gerikkub/CPRC-IGVC/Images/justin kyle working.jpg

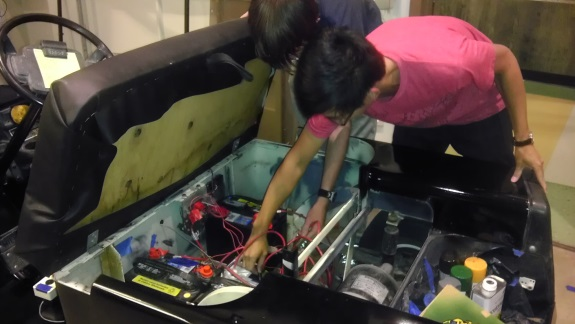
Images/justin kyle working.jpg
