gerikkub/CPRC-IGVC/Images/team work.jpg

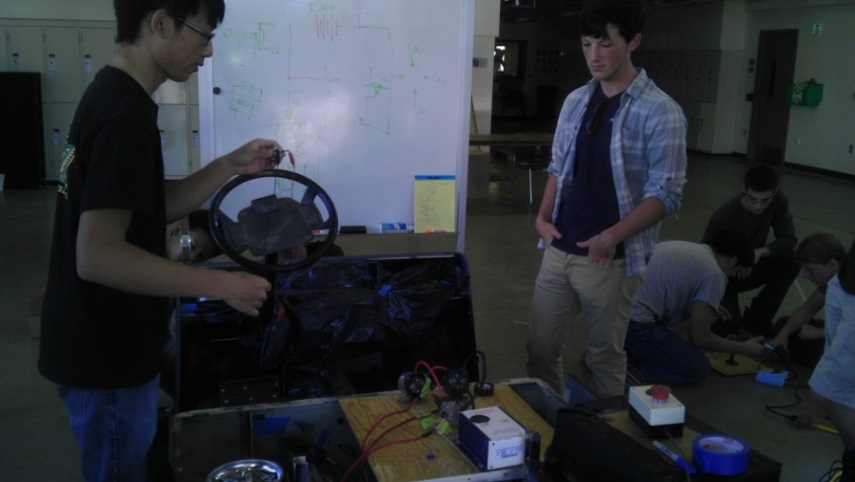
Images/team work.jpg
