gerikkub/CPRC-IGVC/README.md

This is the code repository for the CPRC IGVC project.
Before you commit any changes, please follow the format and inform Jordan Lin
