gerikkub/CPRC-IGVC/Electrical Schematics/IGCV/Images/EZdrive.png

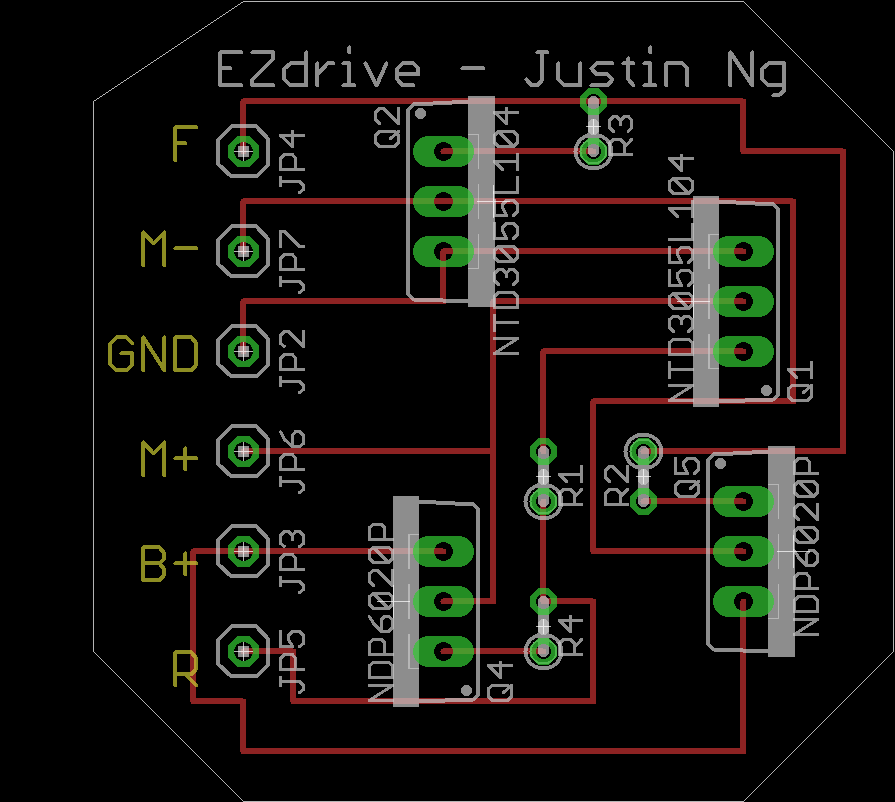
Electrical Schematics/IGCV/Images/EZdrive.png
