gerikkub/CPRC-IGVC/Electrical Schematics/IGCV/Images/FNR Controller v0.0.png

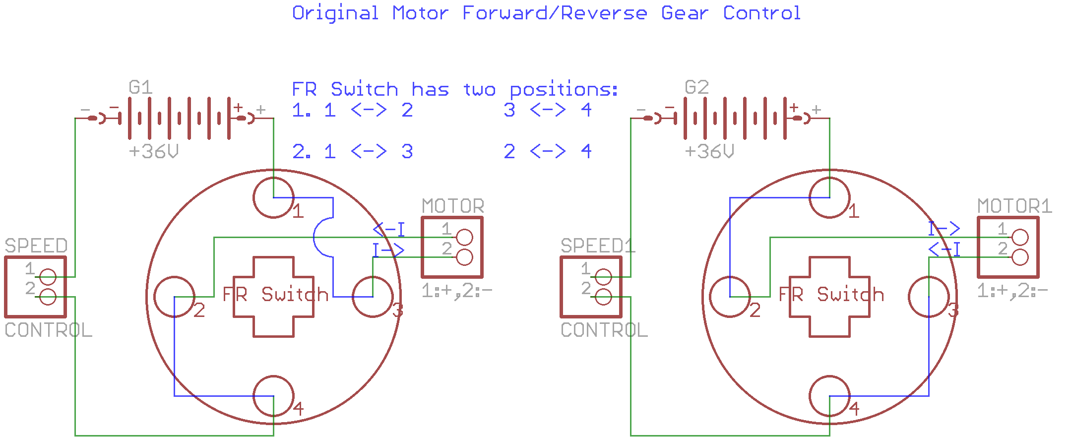
Electrical Schematics/IGCV/Images/FNR Controller v0.0.png
