gerikkub/CPRC-IGVC/Electrical Schematics/IGCV/Images/FNR Controller v1.0 - Relay.png

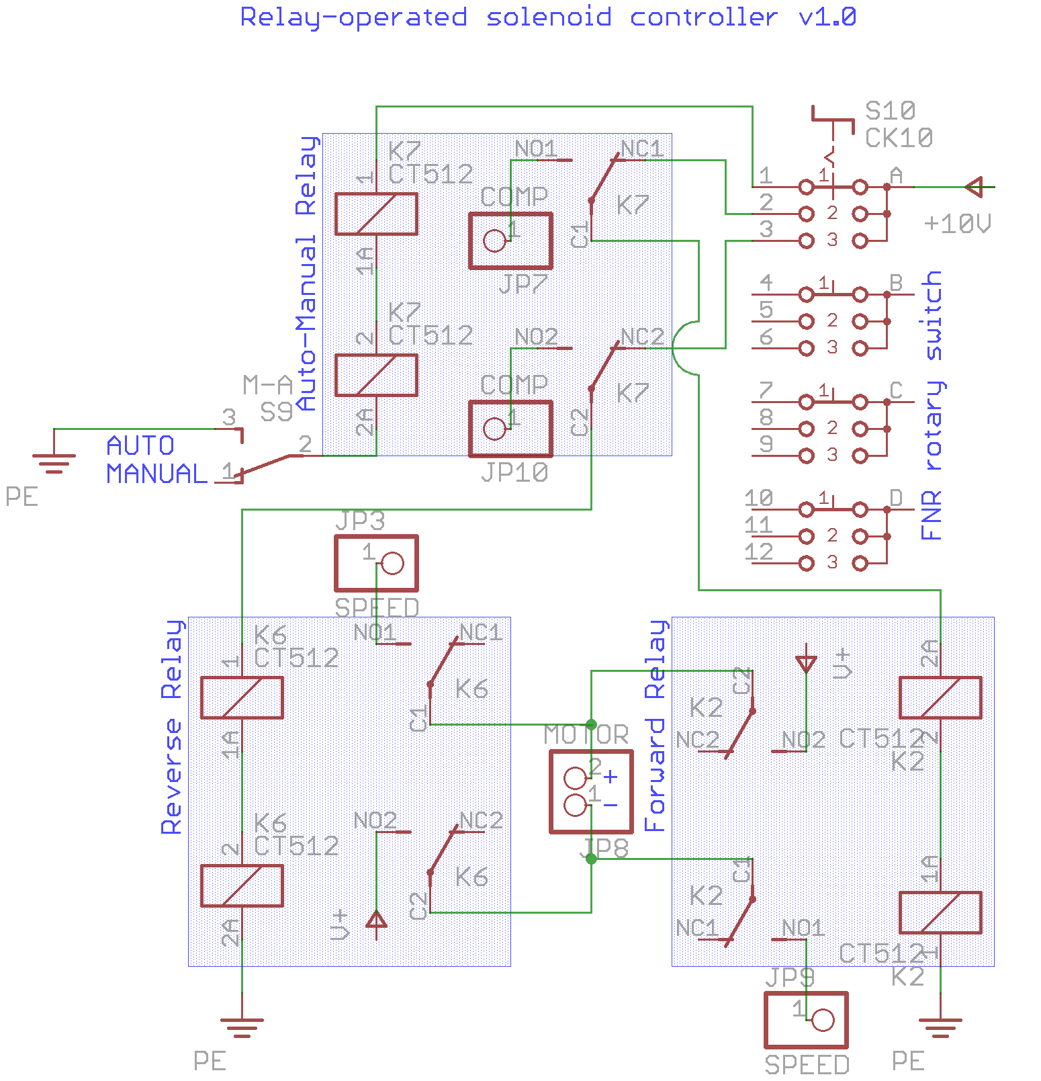
Electrical Schematics/IGCV/Images/FNR Controller v1.0 - Relay.png
