gerikkub/CPRC-IGVC/Electrical Schematics/IGCV/Images/FNR Controller v1.1 - Relay.png

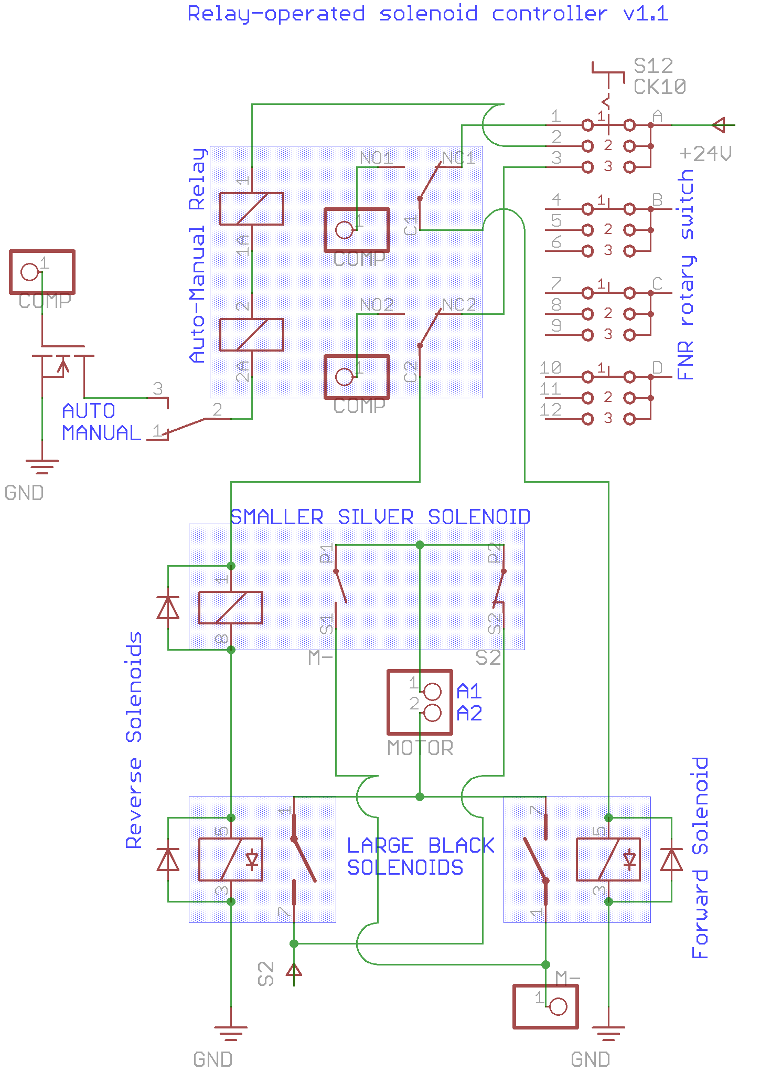
Electrical Schematics/IGCV/Images/FNR Controller v1.1 - Relay.png
