gerikkub/CPRC-IGVC/Electrical Schematics/IGCV/Images/FNR Controller v1.2 - Solid state.png

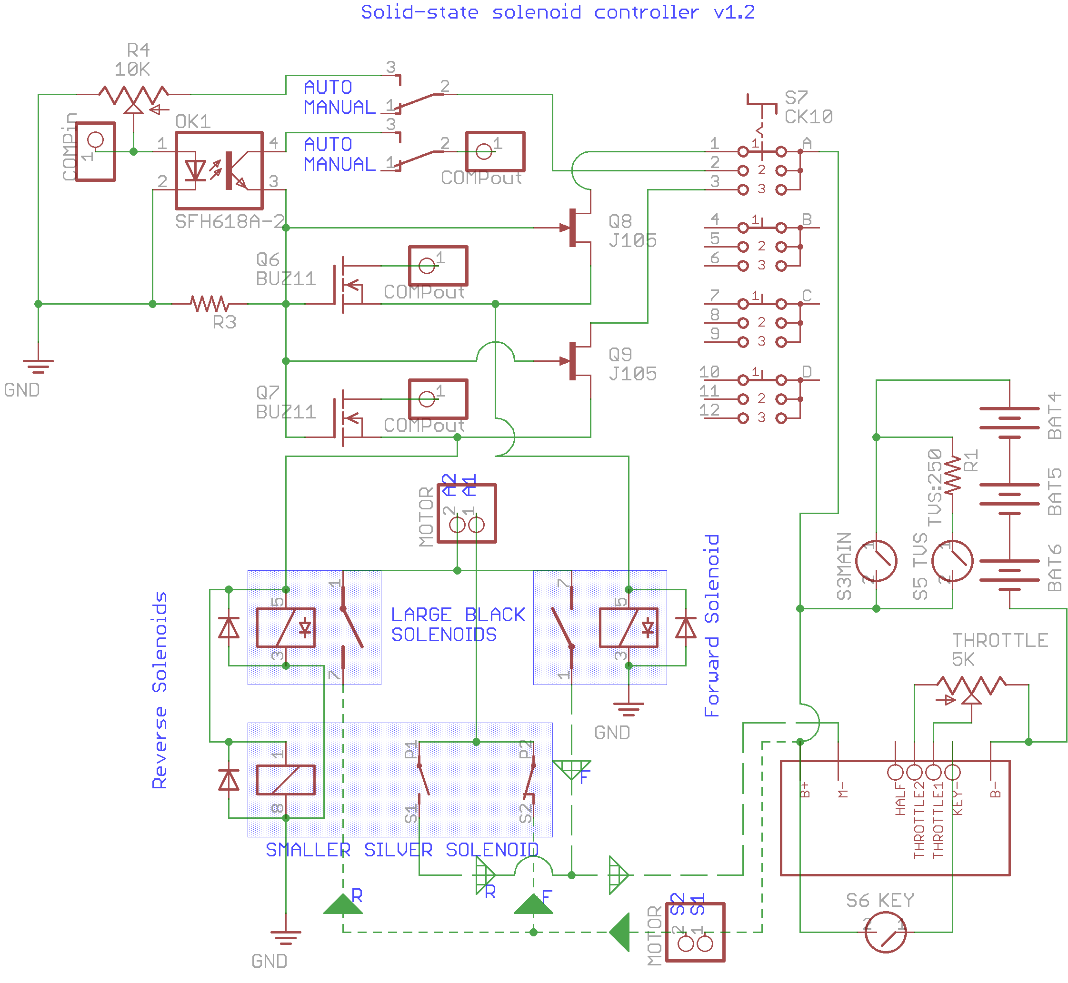
Electrical Schematics/IGCV/Images/FNR Controller v1.2 - Solid state.png
