gerikkub/CPRC-IGVC/Electrical Schematics/IGCV/Images/FNR v1.4 + Speed v1.2.png

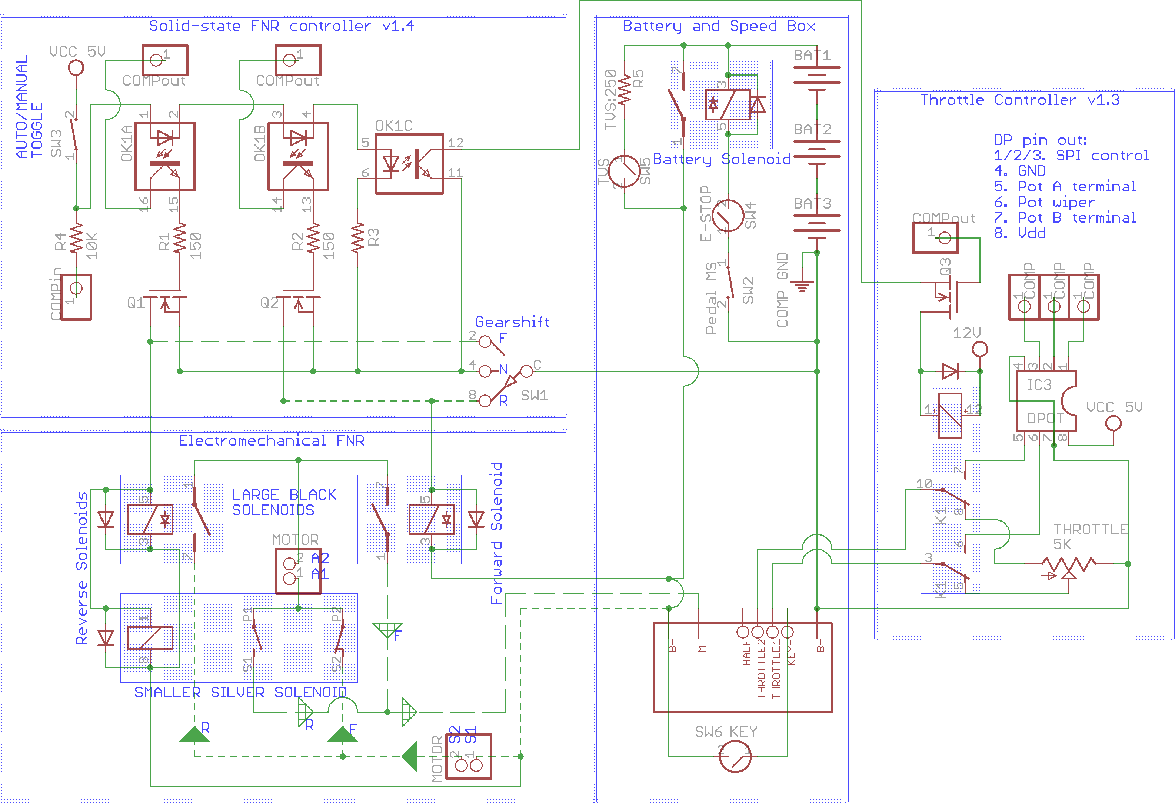
Electrical Schematics/IGCV/Images/FNR v1.4 + Speed v1.2.png
