gerikkub/CPRC-IGVC/Electrical Schematics/IGCV/Images/IGVC Controller v1.6.png

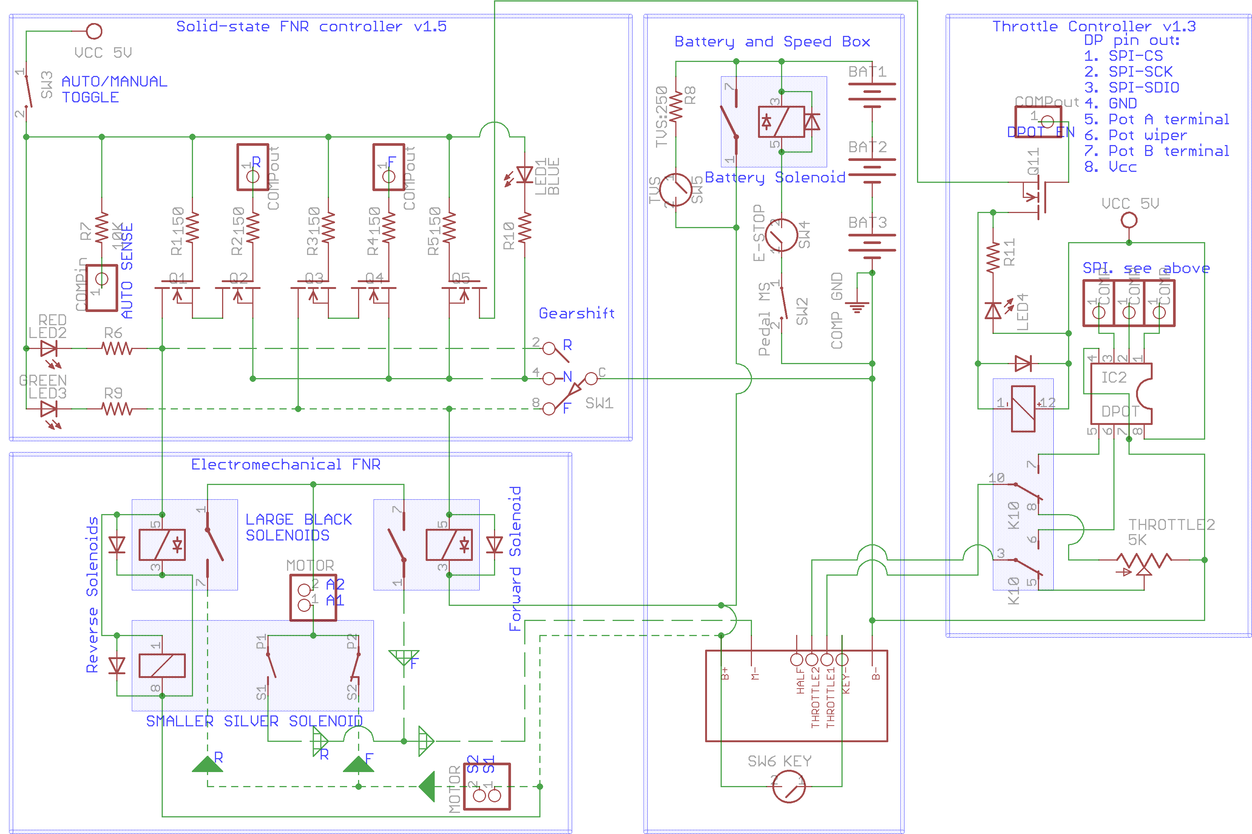
Electrical Schematics/IGCV/Images/IGVC Controller v1.6.png
