gerikkub/CPRC-IGVC/Electrical Schematics/IGCV/Images/Speed Controller v1.0.png

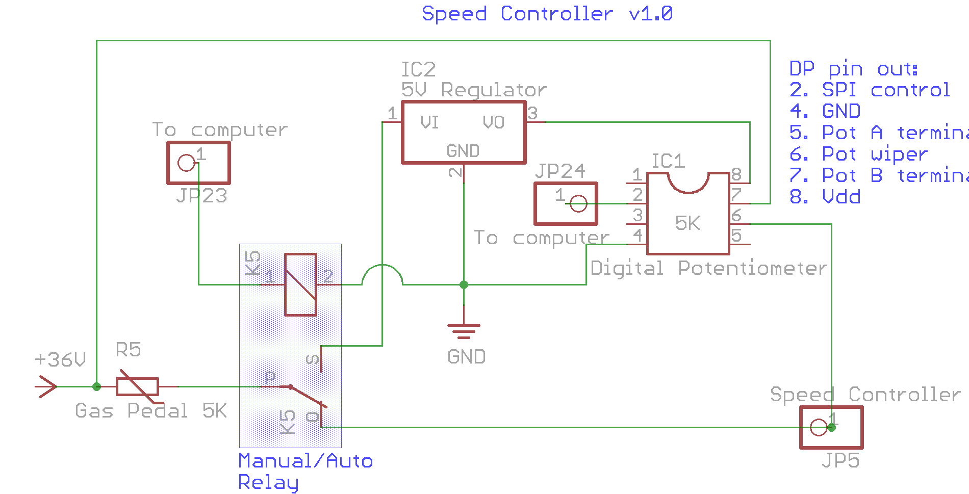
Electrical Schematics/IGCV/Images/Speed Controller v1.0.png
