gerikkub/CPRC-IGVC/Images/DSC_0002.JPG

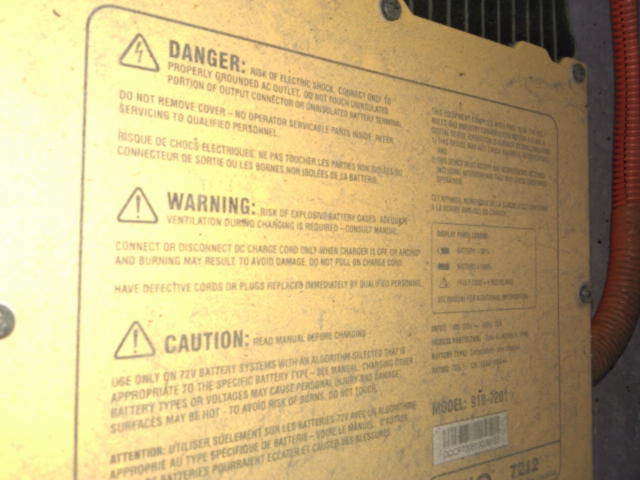
Images/DSC_0002.JPG
