gerikkub/CPRC-IGVC/Images/vehicle.jpg

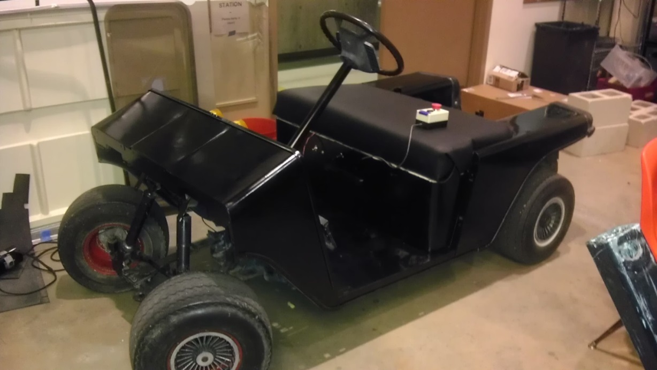
Images/vehicle.jpg
