gerikkub/CPRC-IGVC/Code/Software Implementation/FunctionsTest.xlsx

FUNCTIONS | WORKING | NOT WORKING
void setFNR(int FNR)
STEERING
void turn(float input)
void SetSteeringAngle(int targetAngle)
void Straighten( )
READING VALUES
int readUSensor(int sensor)
int readSteering(int pin)
int readHallEffects(int pin)
int readAMS(int pin)
float sideAngleToWall(int side)
NETWORKING
String toJSON( )
int dealWithInput( )
void parseJson( )
AVOIDANCE
void shyAway( )
void parallelToWall( )
