gerikkub/CPRC-IGVC/Electrical Schematics/IGCV/FNR Build day test.sch

## EAGLE design Electrical Schematics/IGCV/FNR Build day test.sch (2013-10-28)

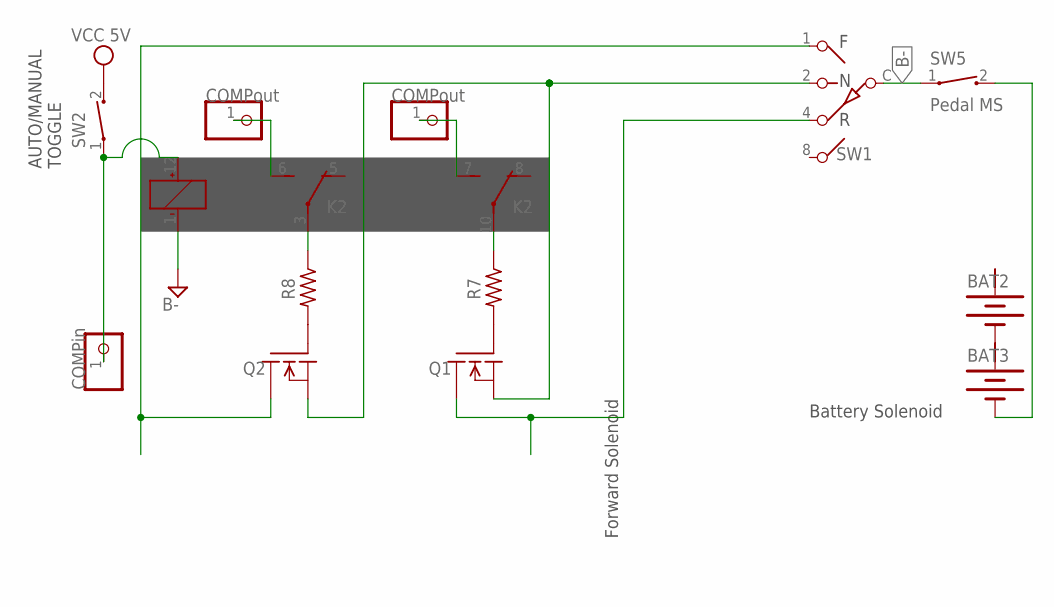
[picture p14: schematic FNR Build day test.sch]

Parts:
BAT2, BAT3: BATTERY
JP4, JP22: COMPout; 1X01
JP6: COMPin; 1X01
K2: DF2-L-DC24V; DF2
Q1, Q2: BUZ11; TO220
R7, R8: R-US_0204/5; 0204/5
SW1: SW-C10
SW2, SW5: Pedal MS; CT10-XXXX-A2

Connections:
B-: BAT3.-, Q1.3 (S), Q2.3 (S), SW1.2, SW5.2
FGND: Q1.2 (D), SW1.4
GND1: K2.1 (-)
unnamed: JP4.1, K2.6 (S)
unnamed: JP22.1, K2.7 (S)
unnamed: BAT2.-, BAT3.+
unnamed: K2.10, R7.1
unnamed: Q2.1 (G), R8.2
unnamed: Q1.1 (G), R7.2
unnamed: K2.3, R8.1
unnamed: JP6.1, K2.12 (+), SW2.1
unnamed: SW1.C, SW5.1
RGND: Q2.2 (D), SW1.1
VCC: SW2.2

Notes on the sheet:
Forward Solenoid
AUTO/MANUAL TOGGLE
Battery Solenoid
F N R
