gerikkub/CPRC-IGVC/Electrical Schematics/IGCV/FNR Controller v0.0 - Original.sch

## EAGLE design Electrical Schematics/IGCV/FNR Controller v0.0 - Original.sch (2013-10-28)

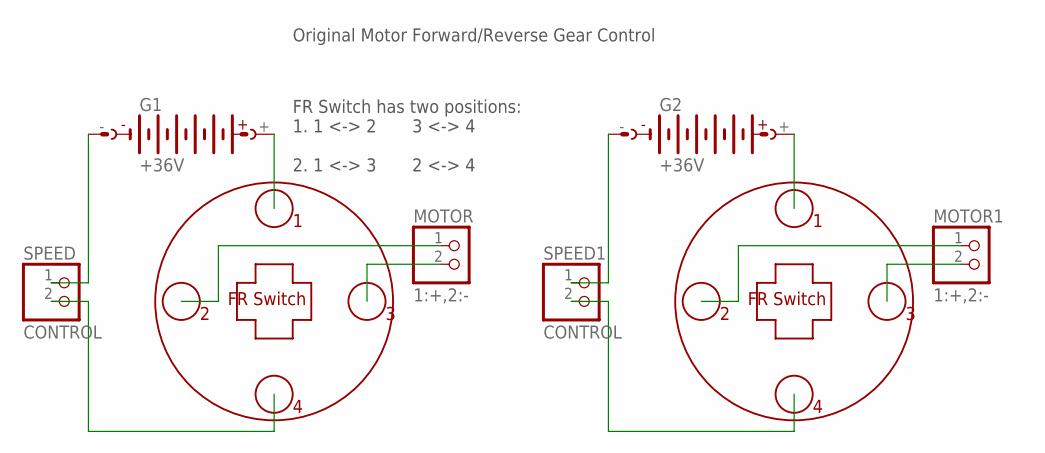
[picture p15: schematic FNR Controller v0.0 - Original.sch]

Parts:
G1, G2: +36V; AB9V
MOTOR, MOTOR1: 1:+,2:-; 1X02
SPEED, SPEED1: CONTROL; 1X02
U$1, U$3: FRSWITCH; DIL08-ROUND

Connections:
unnamed: G1.+, U$1.1
unnamed: G1.-, SPEED.1
unnamed: SPEED.2, U$1.4
unnamed: MOTOR.2, U$1.2
unnamed: MOTOR.1, U$1.3
unnamed: G2.+, U$3.1
unnamed: G2.-, SPEED1.1
unnamed: SPEED1.2, U$3.4
unnamed: MOTOR1.2, U$3.2
unnamed: MOTOR1.1, U$3.3

Notes on the sheet:
FR Switch has two positions: 1. 1 <-> 2 3 <-> 4 2. 1 <-> 3 2 <-> 4
Original Motor Forward/Reverse Gear Control
