gerikkub/CPRC-IGVC/Electrical Schematics/IGCV/FNR Controller v1.0 - Relay.sch

## EAGLE design Electrical Schematics/IGCV/FNR Controller v1.0 - Relay.sch (2013-10-28, an earlier design)

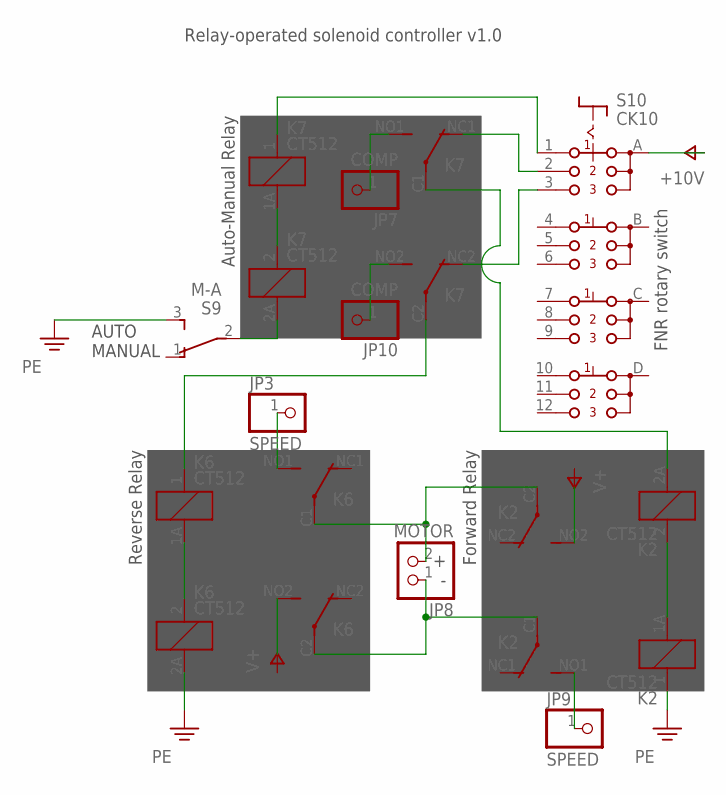
[picture p16: schematic FNR Controller v1.0 - Relay.sch]

Parts:
JP3, JP9: SPEED; 1X01
JP7, JP10: COMP; 1X01
JP8: MOTOR; 1X02
K2, K6, K7: CT512; CT2-TWIN
S9: M-A; TL3XPO
S10: CK10

Connections:
unnamed: JP8.1, K2.C1, K6.C2
unnamed: JP8.2, K2.C2, K6.C1
unnamed: K6.1A (2), K6.2 (1)
unnamed: K2.1A (2), K2.2 (1)
unnamed: JP9.1, K2.NO1 (S)
unnamed: JP3.1, K6.NO1 (S)
unnamed: K6.1, K7.C2
unnamed: K7.1A (2), K7.2 (1)
unnamed: K7.2A (2), S9.2
unnamed: JP7.1, K7.NO1 (S)
unnamed: JP10.1, K7.NO2 (S)
unnamed: K7.1, S10.1 (A1)
unnamed: K7.NC1 (O), S10.2 (A2)
unnamed: K7.NC2 (O), S10.3 (A3)
unnamed: K2.2A (2), K7.C1
PE: K2.1, K6.2A (2), S9.3 (S)
V+: S10.A

Notes on the sheet:
+ -
AUTO MANUAL
FNR rotary switch
Auto-Manual Relay
Forward Relay
Reverse Relay
Relay-operated solenoid controller v1.0
