gerikkub/CPRC-IGVC/Electrical Schematics/IGCV/FNR Controller v1.1 - Relay.sch

## EAGLE design Electrical Schematics/IGCV/FNR Controller v1.1 - Relay.sch (2013-10-28)

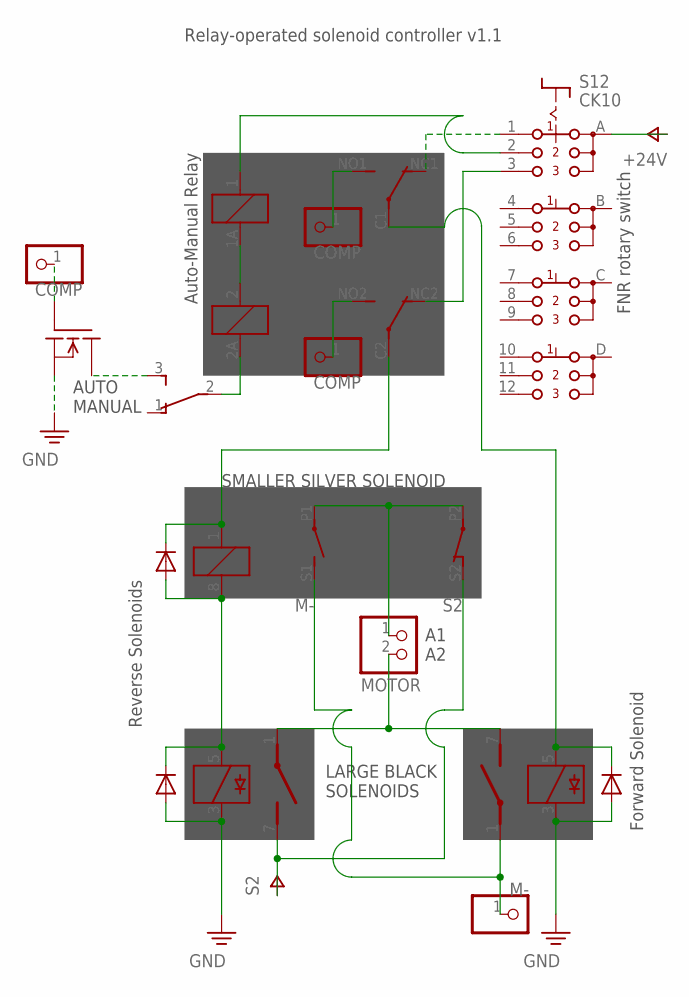
[picture p17: schematic FNR Controller v1.1 - Relay.sch]

Parts:
D4, D5, D6: 1N4004; DO41-10
JP12, JP20, JP21: COMP; 1X01
JP18: MOTOR; 1X02
JP19: M-; 1X01
K11: CT512; CT2-TWIN
K12, K13: 35701331; REED
K14: G6C-2117P
Q3: BUZ11; TO220
S11: M-A; TL3XPO
S12: CK10

Connections:
M-: JP19.1, K13.1, K14.S1 (S)
unnamed: JP18.2, K12.1, K13.7 (S)
unnamed: D5.C, K11.C2, K14.1
unnamed: K11.1A (2), K11.2 (1)
unnamed: K11.2A (2), S11.2
unnamed: JP12.1, K11.NO1 (S)
unnamed: JP20.1, K11.NO2 (S)
unnamed: K11.1, S12.2 (A2)
unnamed: D4.C, D5.A, K12.5, K14.8 (2)
unnamed: JP18.1, K14.P1, K14.P2
unnamed: Q3.2 (D), S11.3 (S)
unnamed: JP21.1, Q3.1 (G)
unnamed: K11.NC1 (O), S12.1 (A1)
unnamed: K11.NC2 (O), S12.3 (A3)
unnamed: D6.C, K11.C1, K13.5
PE: D4.A, D6.A, K12.3, K13.3, Q3.3 (S)
S2: K12.7 (S), K14.S2 (O), S12.A

Notes on the sheet:
A1 A2
AUTO MANUAL
FNR rotary switch
Auto-Manual Relay
Forward Solenoid
Reverse Solenoids
SMALLER SILVER SOLENOID
LARGE BLACK SOLENOIDS
Relay-operated solenoid controller v1.1
