gerikkub/CPRC-IGVC/Electrical Schematics/IGCV/FNR Controller v1.2 - Solid state.sch

## EAGLE design Electrical Schematics/IGCV/FNR Controller v1.2 - Solid state.sch (2013-10-28)

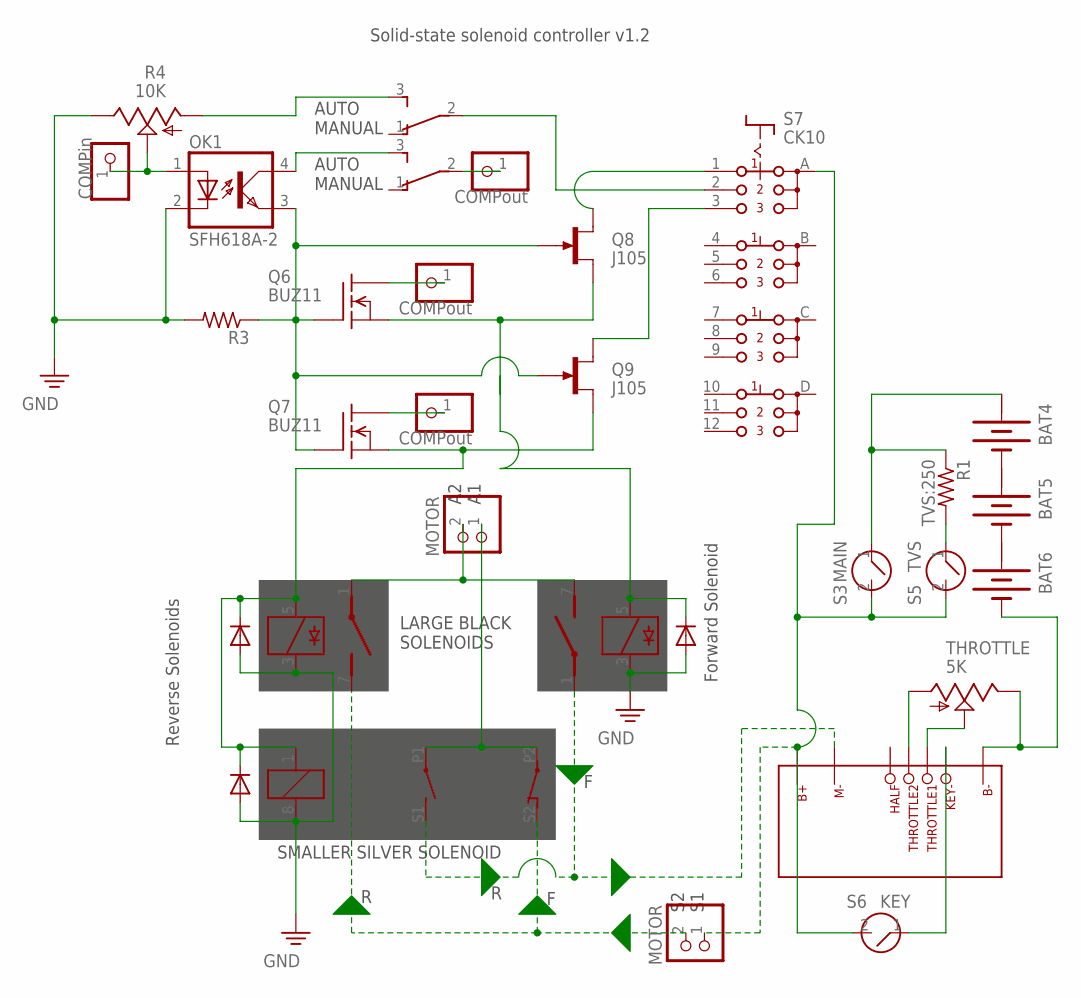
[picture p18: schematic FNR Controller v1.2 - Solid state.sch]

Parts:
BAT4, BAT5, BAT6: BATTERY
D7, D8, D9: 1N4004; DO41-10
JP11, JP13: MOTOR; 1X02
JP14, JP15, JP17: COMPout; 1X01
JP16: COMPin; 1X01
K8, K9: 35701331; REED
K10: G6C-2117P
OK1: SFH618A-2; DIP4
Q6, Q7: BUZ11; TO220
Q8, Q9: J105; TO92R
R1: TVS:250; 0204/5
R3: R-US_0204/5; 0204/5
R4: 10K; CT6
S2, S8: M-A; TL3XPO
S3: MAIN; SWITCH
S5: TVS; SWITCH
S6: KEY; SWITCH
S7: CK10
THROTTLE: 5K; CT6
U$2: MOTOR-CONTROLLER

Connections:
unnamed: OK1.3 (EMIT), Q6.1 (G), Q7.1 (G), Q8.G, Q9.G, R3.1
unnamed: JP16.1, OK1.1 (A), R4.S
unnamed: D7.C, D8.C, K8.5, K10.1, Q7.3 (S), Q9.S
unnamed: JP13.1, S3.2, S5.2, S6.2, S7.A, U$2.P$2 (B+)
unnamed: JP13.2, K8.7 (S), K10.S2 (O)
unnamed: JP17.1, S2.2
unnamed: Q8.D, S7.1 (A1)
unnamed: OK1.4 (COL), S2.3 (S)
unnamed: BAT4.+, R1.1, S3.1
unnamed: R1.2, S5.1
unnamed: JP11.2, K8.1, K9.7 (S)
unnamed: JP11.1, K10.P1, K10.P2
unnamed: BAT4.-, BAT5.+
unnamed: BAT5.-, BAT6.+
unnamed: THROTTLE.S, U$2.P$5 (THROTTLE1)
unnamed: S6.1, U$2.P$4 (KEY-)
unnamed: K9.1, K10.S1 (S), U$2.P$3 (M-)
unnamed: Q9.D, S7.3 (A3)
unnamed: D9.C, K9.5, Q6.3 (S), Q8.S
unnamed: JP14.1, Q6.2 (D)
unnamed: JP15.1, Q7.2 (D)
unnamed: S7.2 (A2), S8.2
unnamed: R4.A, S8.3 (S)
unnamed: BAT6.-, THROTTLE.E, U$2.P$1 (B-)
unnamed: THROTTLE.A, U$2.P$6 (THROTTLE2)
PE: D7.A, D8.A, D9.A, K8.3, K9.3, K10.8 (2), OK1.2 (C), R3.2, R4.E

Notes on the sheet:
A2 A1
Forward Solenoid
Reverse Solenoids
SMALLER SILVER SOLENOID
LARGE BLACK SOLENOIDS
S2 S1
AUTO MANUAL
Solid-state solenoid controller v1.2
