gerikkub/CPRC-IGVC/Electrical Schematics/IGCV/FNR v1.3 + Speed v1.2.sch

## EAGLE design Electrical Schematics/IGCV/FNR v1.3 + Speed v1.2.sch (2013-10-28, an earlier design)

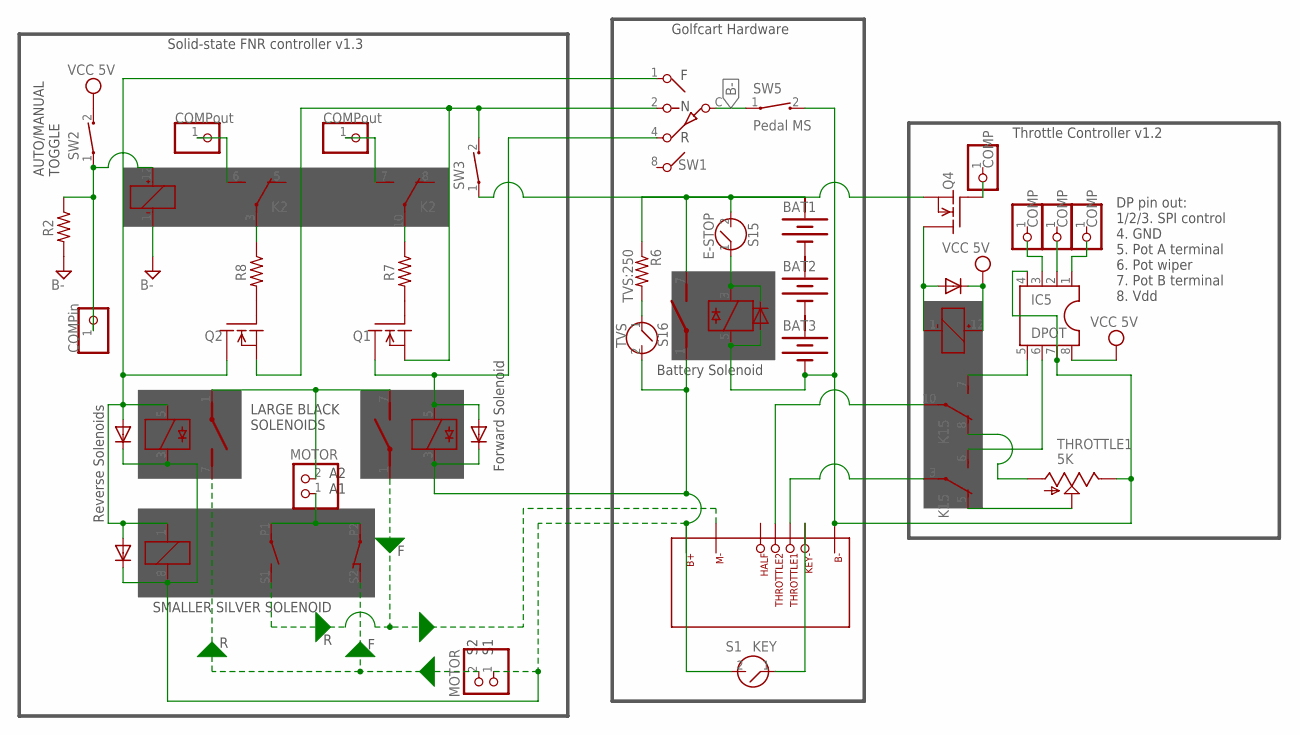
[picture p19: schematic FNR v1.3 + Speed v1.2.sch]

Parts:
BAT1, BAT2, BAT3: BATTERY
D1, D2, D3, D10, D11: 1N4004; DO41-10
IC5: DPOT; DIL08
JP1, JP2: MOTOR; 1X02
JP4, JP22: COMPout; 1X01
JP6: COMPin; 1X01
JP25, JP26, JP27, JP28: COMP; 1X01
K1, K3, K16: 35701331; REED
K2, K15: DF2-L-DC24V; DF2
K4: G6C-2117P
Q1, Q2, Q4: BUZ11; TO220
R2, R7, R8: R-US_0204/5; 0204/5
R6: TVS:250; 0204/5
S1: KEY; SWITCH
S15: E-STOP; SWITCH
S16: TVS; SWITCH
SW1: SW-C10
SW2, SW3, SW5: Pedal MS; CT10-XXXX-A2
THROTTLE1: 5K; CT6
U$4: MOTOR-CONTROLLER

Connections:
A1: JP1.1, K4.P1, K4.P2
A2: JP1.2, K1.1, K3.7 (S)
B+: D1.C, D2.C, D3.C, JP2.1, JP2.2, K1.3, K1.7 (S), K3.3, K4.8 (2), K4.S2 (O), K16.1, S1.2, S16.2, U$4.P$2 (B+)
B-: BAT3.-, D11.A, IC5.4, IC5.7, K16.5, Q1.3 (S), Q2.3 (S), SW1.2, SW3.2, SW5.2, THROTTLE1.E, U$4.P$1 (B-)
FGND: D3.A, K3.5, Q1.2 (D), SW1.4
GND1: K2.1 (-), R2.2
M-: K3.1, K4.S1 (S), U$4.P$3 (M-)
unnamed: JP4.1, K2.6 (S)
unnamed: JP22.1, K2.7 (S)
unnamed: Q4.3 (S), SW3.1
unnamed: BAT1.-, BAT2.+
unnamed: BAT2.-, BAT3.+
unnamed: K15.3, K15.10, U$4.P$5 (THROTTLE1), U$4.P$6 (THROTTLE2)
unnamed: S1.1, U$4.P$4 (KEY-)
unnamed: K2.10, R7.1
unnamed: Q2.1 (G), R8.2
unnamed: Q1.1 (G), R7.2
unnamed: K2.3, R8.1
unnamed: JP6.1, K2.12 (+), R2.1, SW2.1
unnamed: BAT1.+, K16.7 (S), R6.1, S15.2
unnamed: R6.2, S16.1
unnamed: K15.5 (O), THROTTLE1.S
unnamed: IC5.6, K15.6 (S)
unnamed: IC5.5, K15.7 (S)
unnamed: K15.8 (O), THROTTLE1.A
unnamed: SW1.C, SW5.1
unnamed: D10.A, K15.1 (-), Q4.2 (D)
unnamed: D11.C, K16.3, S15.1
RGND: D1.A, D2.A, K1.5, K4.1, Q2.2 (D), SW1.1
VCC: D10.C, IC5.8, K15.12 (+), SW2.2

Notes on the sheet:
A2 A1
Forward Solenoid
Reverse Solenoids
SMALLER SILVER SOLENOID
LARGE BLACK SOLENOIDS
S2 S1
AUTO/MANUAL TOGGLE
Solid-state FNR controller v1.3
DP pin out: 1/2/3. SPI control 4. GND 5. Pot A terminal 6. Pot wiper 7. Pot B terminal 8. Vdd
Throttle Controller v1.2
Golfcart Hardware
Battery Solenoid
F N R
