gerikkub/CPRC-IGVC/Electrical Schematics/IGCV/FNR v1.4 + Speed v1.2.sch

## EAGLE design Electrical Schematics/IGCV/FNR v1.4 + Speed v1.2.sch (2013-10-31, an earlier design)

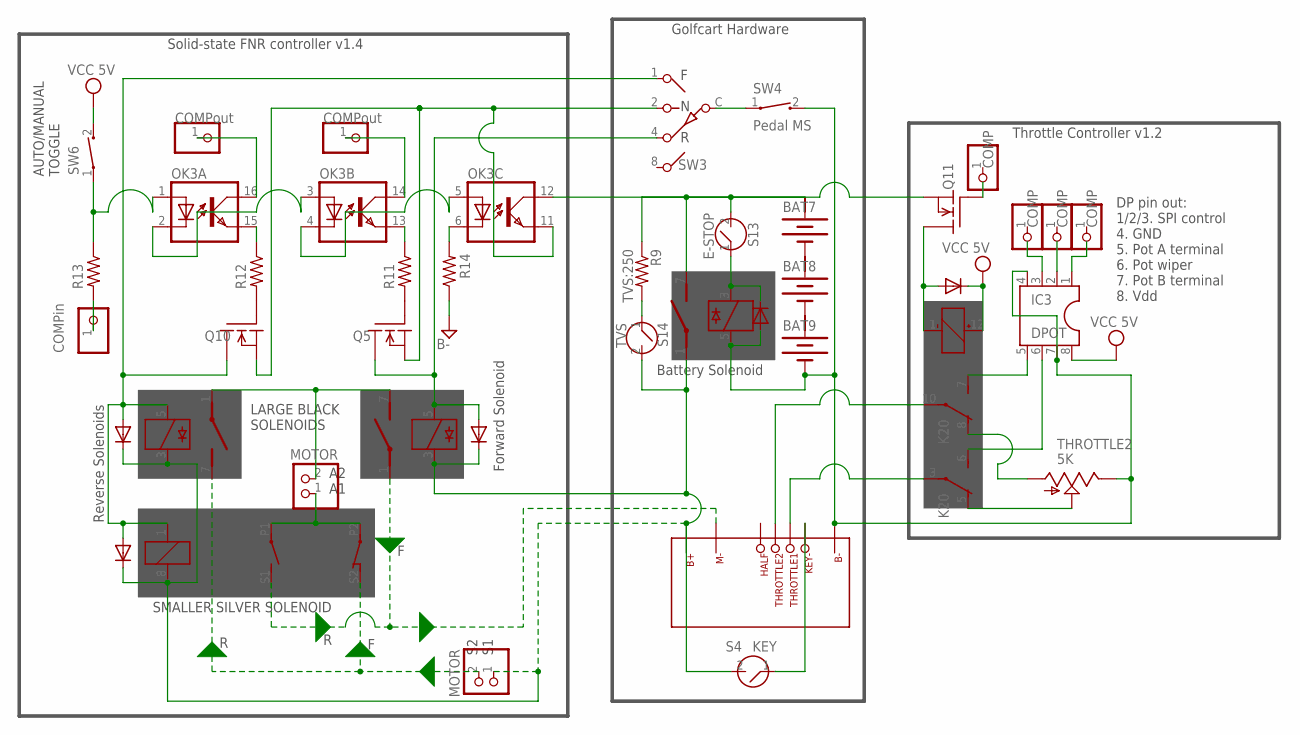
[picture p20: schematic FNR v1.4 + Speed v1.2.sch]

Parts:
BAT7, BAT8, BAT9: BATTERY
D12, D13, D14, D15, D16: 1N4004; DO41-10
IC3: DPOT; DIL08
JP29, JP30: MOTOR; 1X02
JP31: COMPin; 1X01
JP32, JP33: COMPout; 1X01
JP34, JP35, JP36, JP37: COMP; 1X01
K17, K18, K21: 35701331; REED
K19: G6C-2117P
K20: DF2-L-DC24V; DF2
OK3: TLP283-4; MINI-FLAT-16
Q5, Q10, Q11: BUZ11; TO220
R9: TVS:250; 0204/5
R11, R12, R13, R14: R-US_0204/5; 0204/5
S4: KEY; SWITCH
S13: E-STOP; SWITCH
S14: TVS; SWITCH
SW3: SW-C10
SW4, SW6: Pedal MS; CT10-XXXX-A2
THROTTLE2: 5K; CT6
U$5: MOTOR-CONTROLLER

Connections:
A3: JP29.2, K17.1, K18.7 (S)
A4: JP29.1, K19.P1, K19.P2
B+1: D12.C, D13.C, D14.C, JP30.1, JP30.2, K17.3, K17.7 (S), K18.3, K19.8 (2), K19.S2 (O), K21.1, S4.2, S14.2, U$5.P$2 (B+)
B-: BAT9.-, D16.A, IC3.4, IC3.7, K21.5, OK3.11 (EMIT), Q5.3 (S), Q10.3 (S), SW3.2, SW3.C, SW4.1, SW4.2, THROTTLE2.E, U$5.P$1 (B-)
FGND1: D14.A, K18.5, Q5.2 (D), SW3.4
GND1: R14.1
M-1: K18.1, K19.S1 (S), U$5.P$3 (M-)
unnamed: BAT7.-, BAT8.+
unnamed: BAT8.-, BAT9.+
unnamed: S4.1, U$5.P$4 (KEY-)
unnamed: BAT7.+, K21.7 (S), R9.1, S13.2
unnamed: R9.2, S14.1
unnamed: Q10.1 (G), R12.2
unnamed: Q5.1 (G), R11.2
unnamed: JP31.1, R13.2
unnamed: K20.3, K20.10, U$5.P$5 (THROTTLE1), U$5.P$6 (THROTTLE2)
unnamed: K20.5 (O), THROTTLE2.S
unnamed: IC3.5, K20.7 (S)
unnamed: IC3.6, K20.6 (S)
unnamed: K20.8 (O), THROTTLE2.A
unnamed: D15.A, K20.1 (-), Q11.2 (D)
unnamed: D16.C, K21.3, S13.1
unnamed: OK3.4 (C), OK3.5 (A)
unnamed: OK3.6 (C), R14.2
unnamed: OK3.13 (EMIT), R11.1
unnamed: OK3.15 (EMIT), R12.1
unnamed: OK3.2 (C), OK3.3 (A)
unnamed: OK3.1 (A), R13.1, SW6.1
unnamed: JP32.1, OK3.14 (COL)
unnamed: JP33.1, OK3.16 (COL)
RGND1: D12.A, D13.A, K17.5, K19.1, Q10.2 (D), SW3.1
VCC: D15.C, IC3.8, K20.12 (+), SW6.2

Notes on the sheet:
A2 A1
Forward Solenoid
Reverse Solenoids
SMALLER SILVER SOLENOID
LARGE BLACK SOLENOIDS
S2 S1
AUTO/MANUAL TOGGLE
Solid-state FNR controller v1.4
DP pin out: 1/2/3. SPI control 4. GND 5. Pot A terminal 6. Pot wiper 7. Pot B terminal 8. Vdd
Throttle Controller v1.2
Golfcart Hardware
Battery Solenoid
F N R
