gerikkub/CPRC-IGVC/Electrical Schematics/IGCV/FNR v1.4 + Speed v1.3.sch

## EAGLE design Electrical Schematics/IGCV/FNR v1.4 + Speed v1.3.sch (2013-11-03)

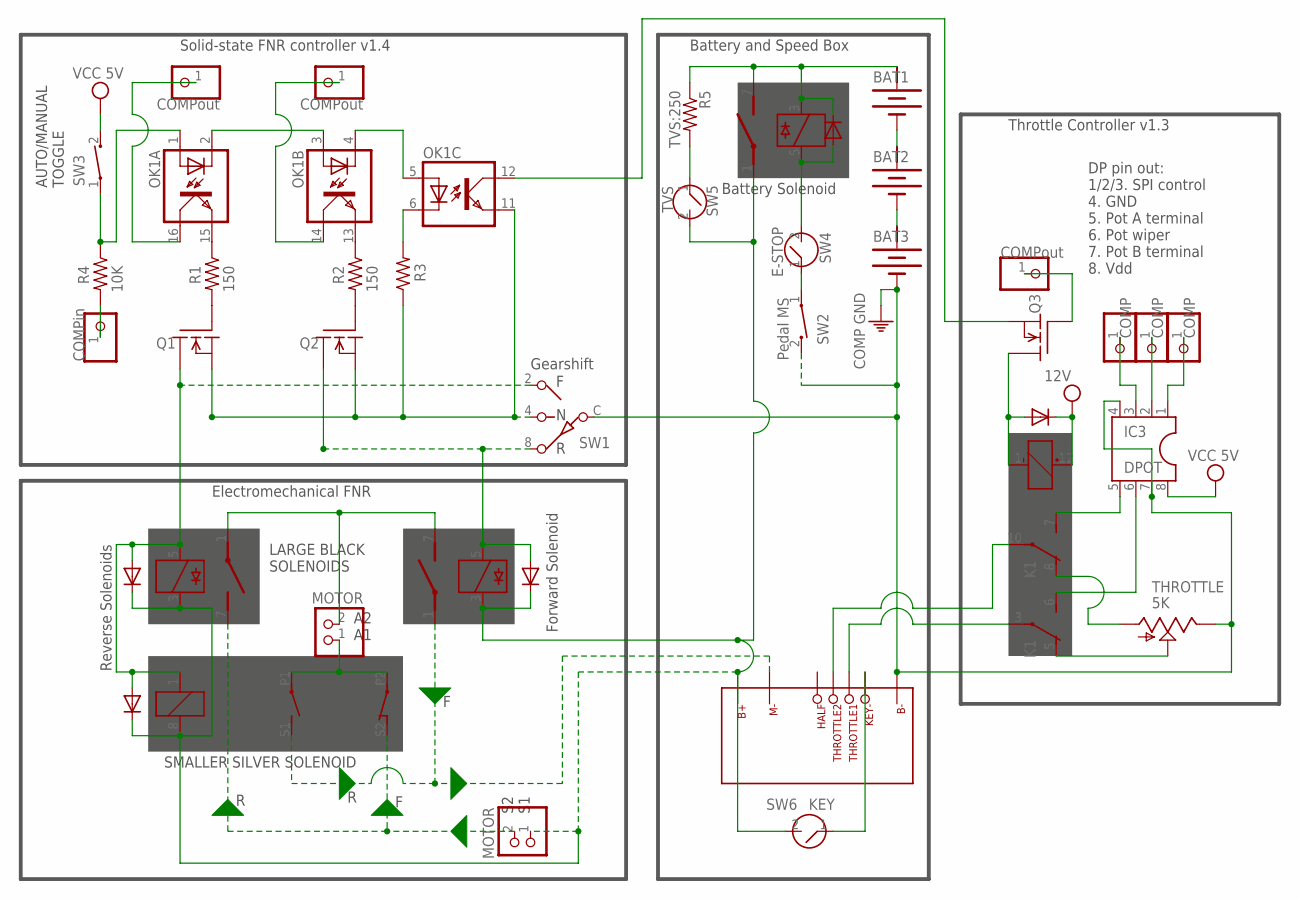
[picture p21: schematic FNR v1.4 + Speed v1.3.sch]

Parts:
BAT1, BAT2, BAT3: BATTERY
D12, D13, D14, D15, D16: 1N4004; DO41-10
IC3: DPOT; DIL08
JP29, JP30: MOTOR; 1X02
JP31: COMPin; 1X01
JP32, JP33, JP37: COMPout; 1X01
JP34, JP35, JP36: COMP; 1X01
K1: DF2-L-DC24V; DF2
K2, K3, K5: 35701331; REED
K4: G6C-2117P
OK1: TLP283-4; MINI-FLAT-16
Q1, Q2, Q3: BUZ11; TO220
R1, R2: 150; 0204/5
R3: R-US_0204/5; 0204/5
R4: 10K; 0204/5
R5: TVS:250; 0204/5
SW1: SW-1P3T; SW-C10
SW2, SW3: Pedal MS; CT10-XXXX-A2
SW4: E-STOP; SWITCH
SW5: TVS; SWITCH
SW6: KEY; SWITCH
THROTTLE: 5K; CT6
U$5: MOTOR-CONTROLLER

Connections:
A3: JP29.2, K2.1, K3.7 (S)
A4: JP29.1, K4.P1, K4.P2
B+: BAT1.+, D12.C, D13.C, D14.C, D16.C, JP30.1, JP30.2, K2.3, K2.7 (S), K3.3, K4.8 (2), K4.S2 (O), K5.1, K5.3, K5.7 (S), R5.1, R5.2, SW5.1, SW5.2, SW6.2, U$5.P$2 (B+)
B-: OK1.11 (EMIT), Q1.3 (S), Q2.3 (S), R3.1, SW1.4 (2)
FGND1: D14.A, K3.5, Q2.2 (D), SW1.8 (4)
M-1: K3.1, K4.S1 (S), U$5.P$3 (M-)
unnamed: D16.A, K5.5, SW4.2
unnamed: K1.10, U$5.P$6 (THROTTLE2)
unnamed: SW2.1, SW4.1
unnamed: OK1.12 (COL), Q3.3 (S)
unnamed: OK1.2 (C), OK1.3 (A)
unnamed: OK1.4 (C), OK1.5 (A)
unnamed: OK1.15 (EMIT), R1.1
unnamed: OK1.13 (EMIT), R2.1
unnamed: OK1.1 (A), R4.1, SW3.1
unnamed: JP33.1, OK1.16 (COL)
unnamed: OK1.6 (C), R3.2
unnamed: JP32.1, OK1.14 (COL)
unnamed: BAT1.-, BAT2.+
unnamed: BAT2.-, BAT3.+
unnamed: SW6.1, U$5.P$4 (KEY-)
unnamed: Q1.1 (G), R1.2
unnamed: Q2.1 (G), R2.2
unnamed: JP31.1, R4.2
unnamed: K1.3, U$5.P$5 (THROTTLE1)
unnamed: K1.5 (O), THROTTLE.S
unnamed: IC3.5, K1.7 (S)
unnamed: IC3.6, K1.6 (S)
unnamed: K1.8 (O), THROTTLE.A
unnamed: IC3.2, JP35.1
unnamed: IC3.1, JP36.1
unnamed: IC3.3, JP34.1
unnamed: D15.A, K1.1 (-), Q3.2 (D)
unnamed: JP37.1, Q3.1 (G)
PE: BAT3.-, IC3.4, IC3.7, SW1.C, SW2.2, THROTTLE.E, U$5.P$1 (B-)
RGND1: D12.A, D13.A, K2.5, K4.1, Q1.2 (D), SW1.2 (1)
VCC: D15.C, IC3.8, K1.12 (+), SW3.2

Notes on the sheet:
A2 A1
Forward Solenoid
Reverse Solenoids
SMALLER SILVER SOLENOID
LARGE BLACK SOLENOIDS
S2 S1
AUTO/MANUAL TOGGLE
Solid-state FNR controller v1.4
DP pin out: 1/2/3. SPI control 4. GND 5. Pot A terminal 6. Pot wiper 7. Pot B terminal 8. Vdd
Throttle Controller v1.3
Battery and Speed Box
Battery Solenoid
F N R
Electromechanical FNR
Gearshift
