gerikkub/CPRC-IGVC/Electrical Schematics/IGCV/IGVC controller v1.6.sch

## EAGLE design Electrical Schematics/IGCV/IGVC controller v1.6.sch (2014-01-18)

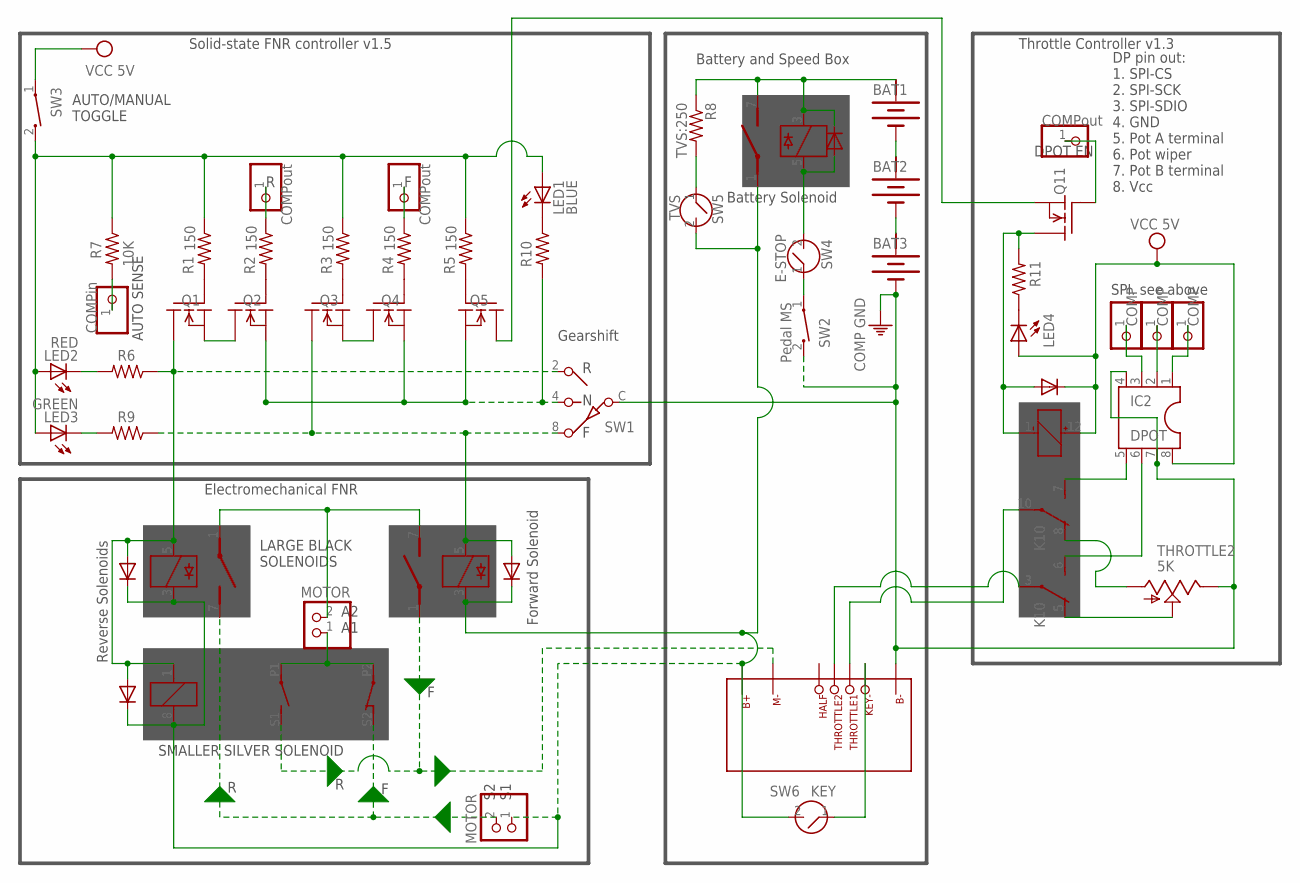
[picture p22: schematic IGVC controller v1.6.sch]

Parts:
BAT1, BAT2, BAT3: BATTERY
D5, D12, D13, D14, D16: 1N4004; DO41-10
IC2: DPOT; DIL08
JP10, JP11, JP12: COMP; 1X01
JP13, JP32, JP33: COMPout; 1X01
JP29, JP30: MOTOR; 1X02
JP31: COMPin; 1X01
K2, K3, K5: 35701331; REED
K4: G6C-2117P
K10: DF2-L-DC24V; DF2
LED1: BLUE; LED3MM
LED2: RED; LED3MM
LED3: GREEN; LED3MM
LED4: LED3MM
Q1, Q2, Q3, Q4, Q5, Q11: BUZ11; TO220
R1, R2, R3, R4, R5: 150; 0204/5@1
R6, R9, R10, R11: R-US_0204/5; 0204/5@1
R7: 10K; 0204/5@1
R8: TVS:250; 0204/5@1
SW1: SW-1P3T; SW-C10
SW2, SW3: Pedal MS; CT10-XXXX-A2
SW4: E-STOP; SWITCH
SW5: TVS; SWITCH
SW6: KEY; SWITCH
THROTTLE2: 5K; CT6
U$5: MOTOR-CONTROLLER

Connections:
+5V: D5.C, IC2.8, K10.12 (+), LED4.A, SW3.1
+36V: BAT1.+, D16.C, K5.3, K5.7 (S), R8.1
A1: JP29.1, K4.P1, K4.P2
A2: JP29.2, K2.1, K3.7 (S)
B+: D12.C, D13.C, D14.C, JP30.1, K2.3, K3.3, K4.8 (2), K5.1, SW5.2, SW6.2, U$5.P$2 (B+)
FGND1: D14.A, K3.5, Q3.2 (D), R9.1, SW1.8 (4)
GND: BAT3.-, IC2.4, IC2.7, SW1.C, SW2.2, THROTTLE2.E, U$5.P$1 (B-)
M-1: K3.1, K4.S1 (S), U$5.P$3 (M-)
N: Q2.3 (S), Q4.3 (S), Q5.3 (S), R10.2, SW1.4 (2)
unnamed: D16.A, K5.5, SW4.2
unnamed: LED4.K (C), R11.1
unnamed: SW2.1, SW4.1
unnamed: Q5.2 (D), Q11.3 (S)
unnamed: Q1.3 (S), Q2.2 (D)
unnamed: Q3.3 (S), Q4.2 (D)
unnamed: Q3.1 (G), R3.2
unnamed: Q4.1 (G), R4.2
unnamed: JP32.1, R4.1
unnamed: JP33.1, R2.1
unnamed: Q5.1 (G), R5.2
unnamed: LED1.A, LED2.A, LED3.A, R1.1, R3.1, R5.1, R7.1, SW3.2
unnamed: LED2.K (C), R6.2
unnamed: LED3.K (C), R9.2
unnamed: LED1.K (C), R10.1
unnamed: K10.3, U$5.P$6 (THROTTLE2)
unnamed: K10.10, U$5.P$5 (THROTTLE1)
unnamed: R8.2, SW5.1
unnamed: K10.5 (O), THROTTLE2.S
unnamed: IC2.5, K10.7 (S)
unnamed: IC2.6, K10.6 (S)
unnamed: K10.8 (O), THROTTLE2.A
unnamed: IC2.2, JP11.1
unnamed: IC2.1, JP12.1
unnamed: IC2.3, JP10.1
unnamed: D5.A, K10.1 (-), Q11.2 (D), R11.2
unnamed: JP13.1, Q11.1 (G)
unnamed: BAT1.-, BAT2.+
unnamed: BAT2.-, BAT3.+
unnamed: SW6.1, U$5.P$4 (KEY-)
unnamed: Q1.1 (G), R1.2
unnamed: Q2.1 (G), R2.2
unnamed: JP31.1, R7.2
RGND: D12.A, D13.A, K2.5, K4.1, Q1.2 (D), R6.1, SW1.2 (1)
S2: JP30.2, K2.7 (S), K4.S2 (O)

Notes on the sheet:
A2 A1
Forward Solenoid
Reverse Solenoids
SMALLER SILVER SOLENOID
LARGE BLACK SOLENOIDS
S2 S1
AUTO/MANUAL TOGGLE
Solid-state FNR controller v1.5
Battery and Speed Box
Battery Solenoid
R N F
Electromechanical FNR
Gearshift
DP pin out: 1. SPI-CS 2. SPI-SCK 3. SPI-SDIO 4. GND 5. Pot A terminal 6. Pot wiper 7. Pot B terminal 8. Vcc
Throttle Controller v1.3
AUTO SENSE
DPOT EN
SPI. see above
