gerikkub/CPRC-IGVC/Electrical Schematics/IGCV/Motor driver.sch

## EAGLE design Electrical Schematics/IGCV/Motor driver.sch (2014-01-18)

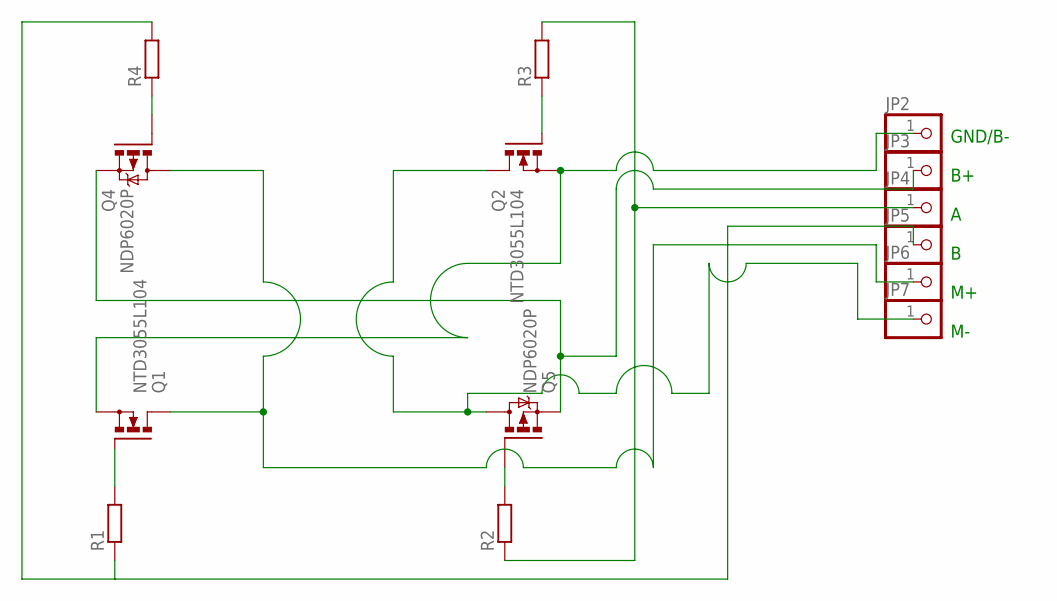
[picture p23: schematic Motor driver.sch]

Parts:
JP2, JP3, JP4, JP5, JP6, JP7: PINHD-1X1; 1X01
Q1, Q2: NTD3055L104; TO220BV
Q4, Q5: NDP6020P; TO220BV
R1, R2, R3, R4: R-EU_0204/2V; 0204V

Connections:
unnamed: Q4.G, R4.1
unnamed: Q2.G, R3.1
unnamed: Q1.G, R1.2
unnamed: Q5.G, R2.2
unnamed: JP5.1, R1.1, R4.2
unnamed: JP4.1, R2.1, R3.2
unnamed: JP3.1, Q4.S, Q5.S
unnamed: JP2.1, Q1.S, Q2.S
unnamed: JP6.1, Q1.D, Q4.D
unnamed: JP7.1, Q2.D, Q5.D

Notes on the sheet:
GND/B- B+ A B M+ M-
