gerikkub/CPRC-IGVC/Electrical Schematics/IGCV/Speed Controller v1.0.sch

## EAGLE design Electrical Schematics/IGCV/Speed Controller v1.0.sch (2013-10-28)

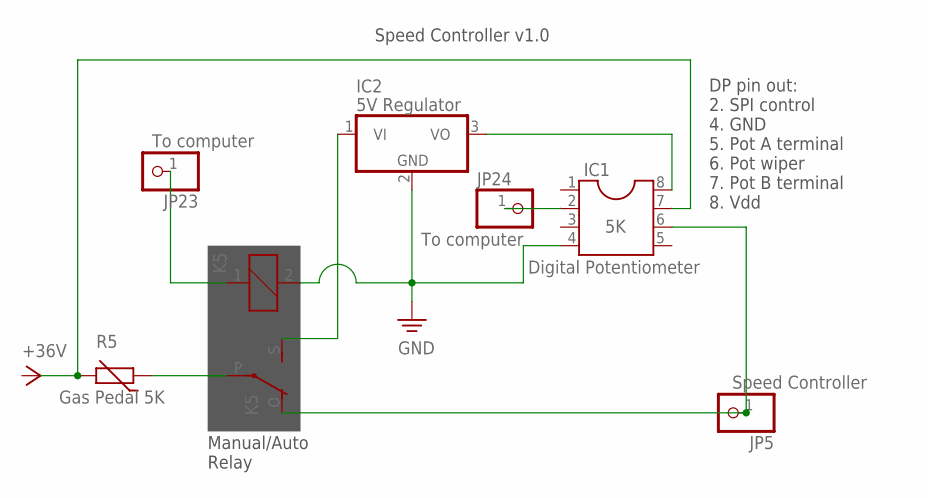
[picture p24: schematic Speed Controller v1.0.sch]

Parts:
IC1: Digital Potentiometer; DIL08
IC2: 5V Regulator; TO220H
JP5: Speed Controller; 1X01
JP23, JP24: To computer; 1X01
K5: G2R
R5: Gas Pedal 5K; R-5

Connections:
unnamed: IC2.1 (VI), K5.S
unnamed: IC1.7, R5.2
unnamed: IC1.6, JP5.1, K5.O
unnamed: K5.P, R5.1
unnamed: JP23.1, K5.1
unnamed: IC1.2, JP24.1
PE: IC1.4, IC2.2 (GND), K5.2
VCC1: IC1.8, IC2.3 (VO)

Notes on the sheet:
DP pin out: 2. SPI control 4. GND 5. Pot A terminal 6. Pot wiper 7. Pot B terminal 8. Vdd
Speed Controller v1.0
Manual/Auto Relay
