gerikkub/CPRC-IGVC/Code/Caddy Board/integration/revA_Alice/usart.c

/***************************
*
* Filename: usart.cpp
*
* Description: Provides print methods for various
*  datatypes using USART.
*
* Authors: Doug Gallatin and Jason Schray
* Edited by: Tim Peters & James Humphrey
*
***************************/

#include "FreeRTOS.h"
#include "semphr.h" 
#include "queue.h"
#include "protocol.h"

#include <stdlib.h>
#include <stdint.h>
#include <avr/io.h>
#include <avr/interrupt.h>


#include "usart.h"

xQueueHandle USART_WriteQueue;
xQueueHandle USART_ReadQueue;
xQueueHandle USART_WriteQueueLog;



/************************************
* Procedure: usart_init
*  
* Description: Initializes the USART module with 
*  the specified baud rate and clk speed.
*
* Param buadin: The desired Baud rate.
* Param clk_seedin: The clk speed of the ATmega328p
************************************/
void USART_Init(uint16_t baudin, uint32_t clk_speedin) {
    USART_WriteQueue = xQueueCreate(64,sizeof(uint8_t));
    USART_ReadQueue = xQueueCreate(8,sizeof(uint8_t));

    uint32_t ubrr = clk_speedin/(16UL)/baudin-1;
    UBRR0H = (unsigned char)(ubrr>>8) ;// & 0x7F;
    UBRR0L = (unsigned char)ubrr;
    
    //UBRR0H = 0; //115200
    //UBRR0L = 8;

    /* Enable receiver and transmitter */
    UCSR0B = (1<<RXEN1)|(1<<TXEN1)|(1<<RXCIE1);
    /* Set frame format: 8data, 1stop bit */
    UCSR0C = (1<<UCSZ11)|(1<<UCSZ10);
	 // clear U2X0 for Synchronous operation
    UCSR0A &= ~(1<<U2X1);

    //UCSR0B |= (1<<UDRIE0);

    //PORTB = 0xFF;

    //UART0 Logging

    /*USART_WriteQueueLog = xQueueCreate(32,sizeof(uint8_t));

    ubrr = clk_speedin/(16UL)/baudin-1;
    UBRR0H = (unsigned char)(ubrr>>8) ;// & 0x7F;
    UBRR0L = (unsigned char)ubrr;
    
    //UBRR0H = 0; //115200
    //UBRR0L = 8;

    /* Enable receiver and transmitter */
    //UCSR0B = (1<<RXEN0)|(1<<TXEN0);
    /* Set frame format: 8data, 1stop bit */
    //UCSR0C = (1<<UCSZ01)|(1<<UCSZ00);
    // clear U2X0 for Synchronous operation
    //UCSR0A &= ~(1<<U2X0);*/

}

/*the send function will put 8bits on the trans line. */
void USART_Write(uint8_t data) {
		/* Wait for empty transmit buffer */
		while ( !( UCSR0A & (1<<UDRE0)) )
		;
		/* Put data into buffer, sends the data */
		UDR0 = data;
}

/*the send function will put 8bits on the trans line. */
void USART_Write_Unprotected(uint8_t data) {
	/* Wait for empty transmit buffer */
	while ( !( UCSR0A & (1<<UDRE0)) )
	;
	/* Put data into buffer, sends the data */
	UDR0 = data;
}

/* the receive data function. Note that this a blocking call
Therefore you may not get control back after this is called 
until a much later time. It may be helpful to use the 
istheredata() function to check before calling this function
        @return 8bit data packet from sender
*/
uint8_t USART_Read(void) {
    /* Wait for data to be received */
    while ( !(UCSR0A & (1<<RXC0)) )
        ;
    /* Get and return received data from buffer */
    return UDR0;
}


ISR(USART1_RX_vect){
    uint8_t data;
    data = UDR1;
    //USART_AddToQueue(data);
    xQueueSendToBackFromISR(USART_ReadQueue,&data,NULL);
}

void USART_AddToQueue(uint8_t data){
    
    xQueueSendToBack(USART_WriteQueue,&data,portMAX_DELAY);

}

void USART_TransmitString(char* str){
    while(*str) {
        USART_AddToQueue(*str);
        str++;
    }
}

void vTaskUSARTWrite(void *pvParameters){
    uint8_t data;
    while(1){
    xQueueReceive(USART_WriteQueue,&data,portMAX_DELAY);

        while(!(UCSR0A & (1<<UDRE0)));
        UDR1 = data;

    }
}

void USART_LogChar(uint8_t data){
    xQueueSendToBack(USART_WriteQueueLog,&data,portMAX_DELAY);
}

void USART_LogString(char* str){
    while(*str){
        USART_LogChar(*str);
        str++;
    }
}

void vTaskUSARTLog(void *pvParameters){
    uint8_t data;
    while(1){
        xQueueReceive(USART_WriteQueueLog,&data,portMAX_DELAY);

        while(!(UCSR0A & (1<<UDRE0)));
        UDR0 = data;

    }

}

uint8_t USART_GetChar(){
    uint8_t data;
    if(xQueueReceive(USART_ReadQueue,&data,1) == pdTRUE){
        //USART_AddToQueue('~');
        return data;
    } else {
        return 255;
    }
}

void vTaskUSARTRead(void *pvParameters){

    char bytesRecieved;
    uint8_t rxData;
    uint8_t buffer[8];
    char size;
    char groupID;
    char cmd;
    unsigned int timeout;

    PORTB = 0;

    Command command;
    Response response;
    while(1){
        //PORTB = 0;
        //Get Header
        bytesRecieved = 0;
        timeout = 0;
        while(bytesRecieved < 4){
            //if there is data to be read...
            //if((UCSR1A & (1<<RXC1))){
            //    rxData = UDR1;
            if((rxData = USART_GetChar()) != 255){
            //if(xQueueReceive(USART_ReadQueue,&rxData,portMAX_DELAY) == pdTRUE){
                buffer[bytesRecieved] = rxData;
                //USART_AddToQueue(rxData);
                bytesRecieved++;
                //timeout = 0;
            } else {
                timeout++;
                PORTB = 0xFF;
            }
            if(timeout > 50000){
                timeout = 0;
                bytesRecieved = 0;
            }
        }
        //PORTB = 0;
        if(calcChecksum(buffer,3) != buffer[3]){
            sendNACK();
        } else {
            sendACK();
            bytesRecieved = 0;
            command.groupID = buffer[0];
            command.cmd = buffer[1];
            command.crc = buffer[3];
            size = buffer[2];
            timeout = 0;
            if(size != 0){
                while(1) {
                    while((bytesRecieved < size+1) && (timeout < 50)){  //1 for crc
                        if(UCSR1A & (1<<RXC1)){
                            rxData = UDR1;

                            //PORTB = 0xFF;
                        //if(xQueueReceive(USART_ReadQueue,&rxData,portMAX_DELAY) == pdTRUE){
                            buffer[bytesRecieved] = rxData;
                            bytesRecieved++;
                        } else {
                            //timeout++;
                            timeout = 1;
                        }
                    } 
                    if(timeout >= 50){
                        break;
                    }
                    if(calcChecksum(buffer,size) != buffer[size]){
                        sendNACK();
                        bytesRecieved = 0;
                    } else {
                        //PORTB = buffer[0];
                        sendACK();
                        memcpy(command.payload,buffer,size);
                        break;
                    }
                }
            }
            processCommand(&command,&response);
            sendResponse(&response);

        }

    }

}

void sendResponse(Response* response){
    char checksumBuffer[2];
    int i;
    while(1){
        USART_AddToQueue(response->commandBack);
        USART_AddToQueue(response->size);
        checksumBuffer[0] = response->commandBack;
        checksumBuffer[1] = response->size;
        USART_AddToQueue(calcChecksum(checksumBuffer,2));
        if(waitForChecksum() == 0){
            break;
        }
    }


    for(i=0;i<response->size;i++){
        USART_AddToQueue(response->payload[i]);
        //USART_AddToQueue(0x30 | (i + 2));
        //USART_AddToQueue()
    }
    USART_AddToQueue(calcChecksum(response->payload,12));


}

void sendACK(){
    USART_AddToQueue(128);
}

void sendNACK(){
    USART_AddToQueue(0);
}

char waitForChecksum(){
    while(1){
        //if(UCSR1A & (1<<RXC1)){
            if(USART_GetChar() == 0xFF){
            //if(UDR1 = 0xFF) {

                return 0;
            } else {
                return -1;
            }

        //} else {
        //    vTaskDelay(1);
        //}

    }
}

uint8_t calcChecksum(uint8_t* buffer,uint8_t size){
    uint8_t checksum = 0;
    for(int i = 0; i < size; i++) {
        checksum += *(buffer++);
    }
    return checksum;
}
