gerikkub/CPRC-IGVC/Code/Software Implementation/Prototypes/frontPanel/frontPanel.h

#define FORWARDS_DISPLAY 0x0001
#define NEUTRAL_DISPLAY 0x0002
#define REVERSE_DISPLAY 0x0004
#define THROTTLE_25_DISPLAY 0x0008
#define THROTTLE_50_DISPLAY 0x0010
#define THROTTLE_75_DISPLAY 0x0020
#define THROTTLE_100_DISPLAY 0x0040
#define STEERING_30_DISPLAY 0x0080
#define STEERING_60_DISPLAY 0x0100
#define STEERING_90_DISPLAY 0x0200
#define STEERING_120_DISPLAY 0x0400
#define STEERING_150_DISPLAY 0x0800
#define FRONT_DISPLAY 0x1000
#define LEFT_DISPLAY 0x2000
#define RIGHT_DISPLAY 0x4000

int updateDisplay(int FNR, int throttle, int steering, char FLR);
void driveDisplay(int outputDisplay);
