gerikkub/CPRC-IGVC/(commit log)

2013-10-27 IMU working
2013-10-28 Organized
    Reorganized all documents into proper folders
    [Arduino MEGA Reference Design.brd, Arduino MEGA Reference Design.sch, FNR Controller v0.0 - Original.sch, FNR Controller v1.0 - Relay.sch, FNR Controller v1.1 - Relay.sch, FNR Controller v1.2 - Solid state.sch, FNR v1.3 + Speed v1.2.sch, FNR v1.4 + Speed v1.2.sch]
2013-10-28 Removed extras
    [FNR Build day test.sch]
2013-10-28 Added schematic images
2013-10-28 Fixed schematic error
2013-10-28 Updated schematics
    [FNR v1.3 + Speed v1.2.sch, FNR v1.4 + Speed v1.2.sch]
2013-11-03 updated schematic
    [FNR v1.4 + Speed v1.3.sch]
2013-11-09 Calculations for steering
2013-11-10 Added angle detection from sonar
2013-11-12 Create Get Current Steering Angle
    Joe,
    Here's the code for Derek and Alex came up with for getting the angle the front wheels are currently set to. I've edited it for correctness.
    Thanks,
    Tim
2013-11-16 Create Network
    This is the Network file used to test the connection between the beags and the arduino
2013-11-16 Updated port listings, sorry about the confusing information.
    Theres really no convenient way to have all the sensors wired.
2013-11-16 front display prototype
2013-11-16 Update Network.ino
    added sideAngleToWall, still need to input num for side sensors
2013-11-17 reorganised front panel into arduino structure
2013-11-17 Debugged front panel driver
2013-11-17 Create SteeringControl-Alpha
2013-11-17 Update SteeringControl-Alpha
2013-11-20 display board layout and hall effect calculations
    [Hall effect calculations.xlsx]
2013-11-23 Update Network.ino
    Put in the input check that Ian and I were working on. Once input works i.e. "FOUND THE C" prints. Then delete that block of code and uncomment the actual loop.
2013-11-23 Likely Plan B
    Due to significant technical difficulties, it is likely that milestone 2 will be completed with only the arduino. This code allows the arduino to compute all the logic and control by itself. The only implementation required for full operation is turnLeft() and turnRight() which is waiting for Robert. But first we have to get the steering to fully function before.
2013-11-23 Moved folders into Software Implementation
    [FunctionsTest.xlsx]
2013-11-24 Create ShyAway.c
    This uses two sensors to navigate through a gate
2013-11-24 Create ShyAway.c
    Uses three sensor values to navigate through the gate
2013-11-24 Create ShyAwaySimple.c
    Simple version of ShyAway.c. Car stops when both sensors hit an object.
2014-01-18 electrical schematic updates
    [IGVC controller v1.6.sch, Motor driver.sch]
2014-02-01 Begin code reorganisation
    [FunctionsTest.xlsx]
2014-02-02 Added three processes to protocol.h: Brakes, Lights, Battery
2014-02-02 Fixed stupid file names
    [main.c]
2014-02-16 fixed communication without input payload
    [Sonar.c, Sonar.h, protocol.c, read_port.cpp, usart.c]
2014-03-01 Added USART Interrupt RX
2014-03-01 More work on Rx Interrupts
2014-03-08 replaced a potentially problematic while loop
    [usart.c]
2014-04-26 added lidar information
2014-05-03 added uart stuff
2014-05-18 Fixed more comm code
    [main.cpp]
